hborisov/thermometer/README.md

# thermometer

https://hristoborisov.wordpress.com/digital-thermometer-with-pic-mcu-and-tmp102-sensor/
