hborisov/thermometer/thermometer.png

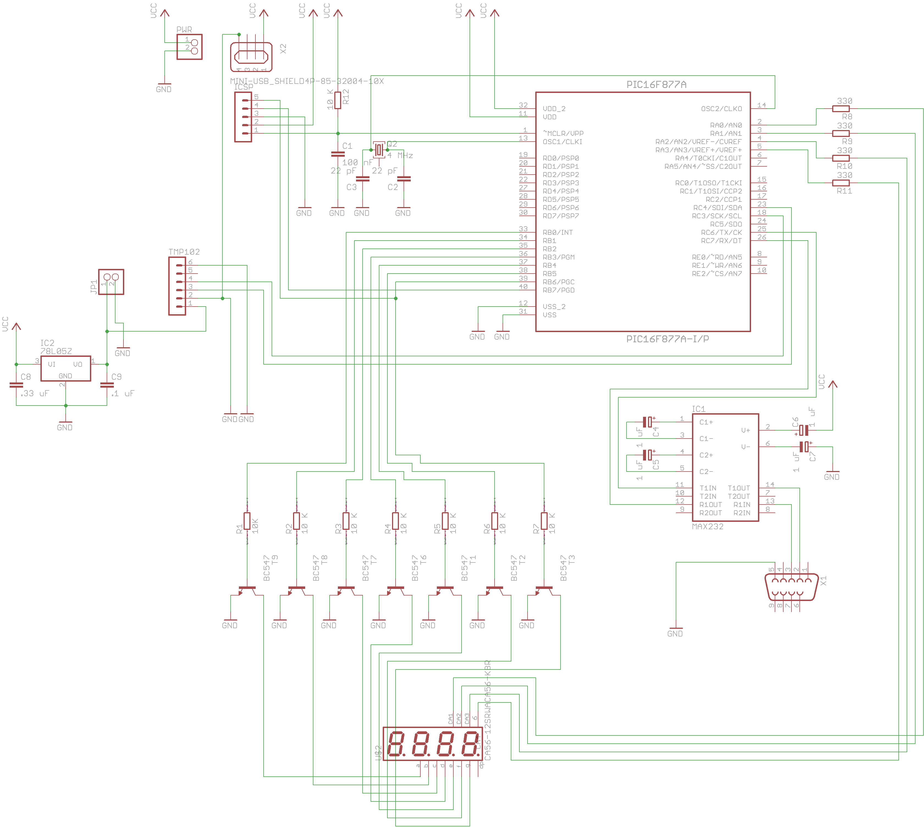
thermometer.png
