hborisov/thermometer/thermometer_brd.png

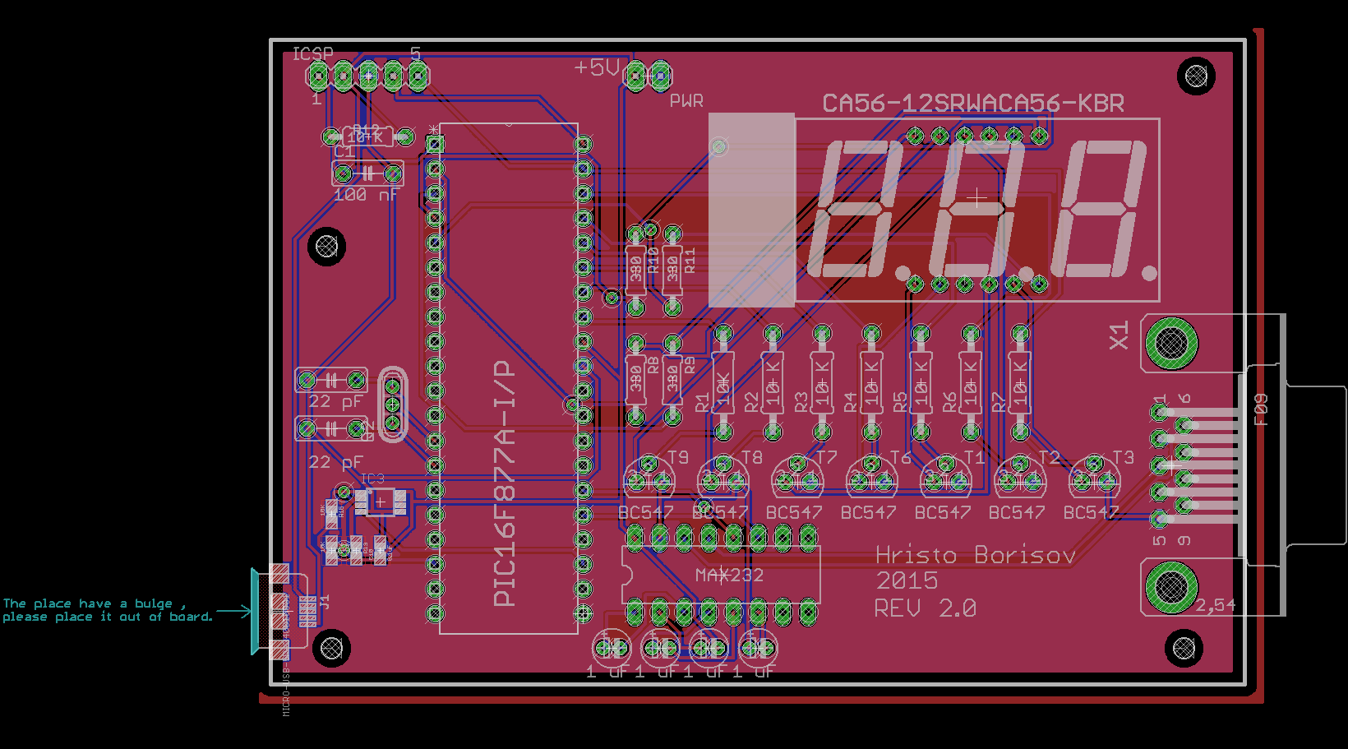
thermometer_brd.png
