hborisov/thermometer/thermometer_sch.png

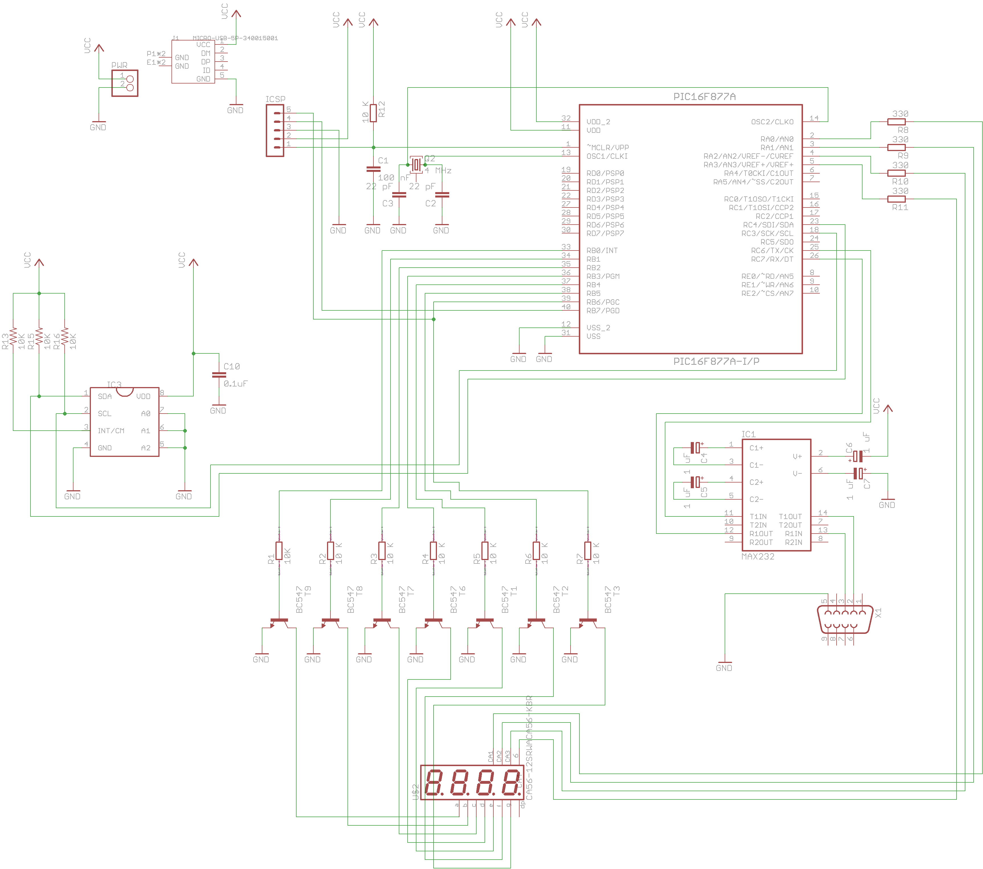
thermometer_sch.png
