hborisov/thermometer/case/rev.1/thermometer_box_top.stl

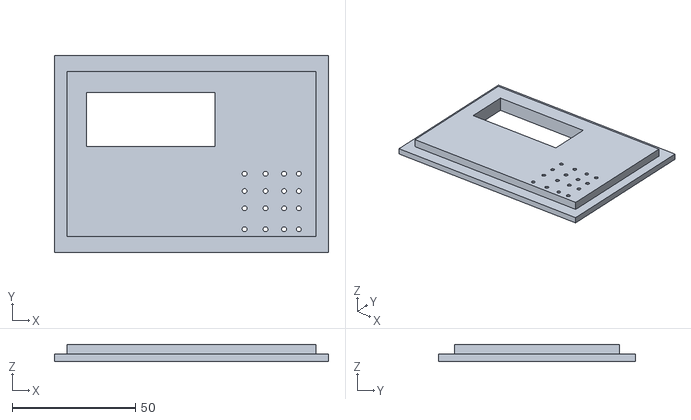
[picture p4: CAD file, 2015-10-23]
case/rev.1/thermometer_box_top.stl
111.0 x 80.0 x 7.00
