hborisov/thermometer/case/rev.1/tremendous_vihelmo.obj

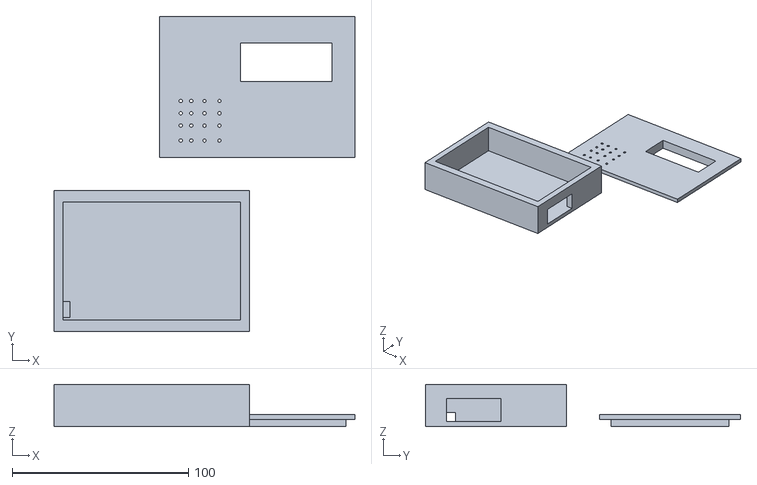
[picture p5: CAD file, 2015-10-23]
case/rev.1/tremendous_vihelmo.obj
171.0 x 179.0 x 24.0
