hborisov/thermometer/case/rev.1/thermometer_box_bottom.stl

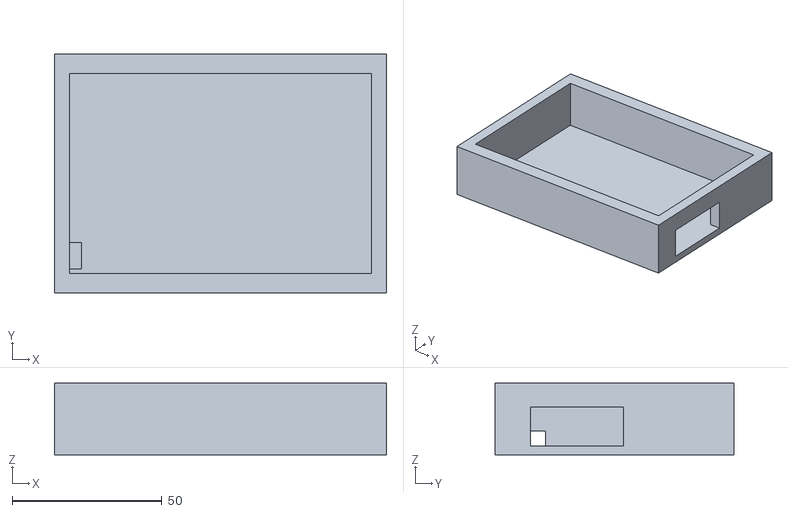
[picture p6: CAD file, 2015-10-23]
case/rev.1/thermometer_box_bottom.stl
111.0 x 80.0 x 24.0
