hborisov/thermometer/(list of files, cad)

Other CAD files:
case/rev.1/thermometer_box.stl
case/rev.1/thermometer_box.amf
