hborisov/thermometer/thermometer.brd

## EAGLE design thermometer.brd (2015-02-23)

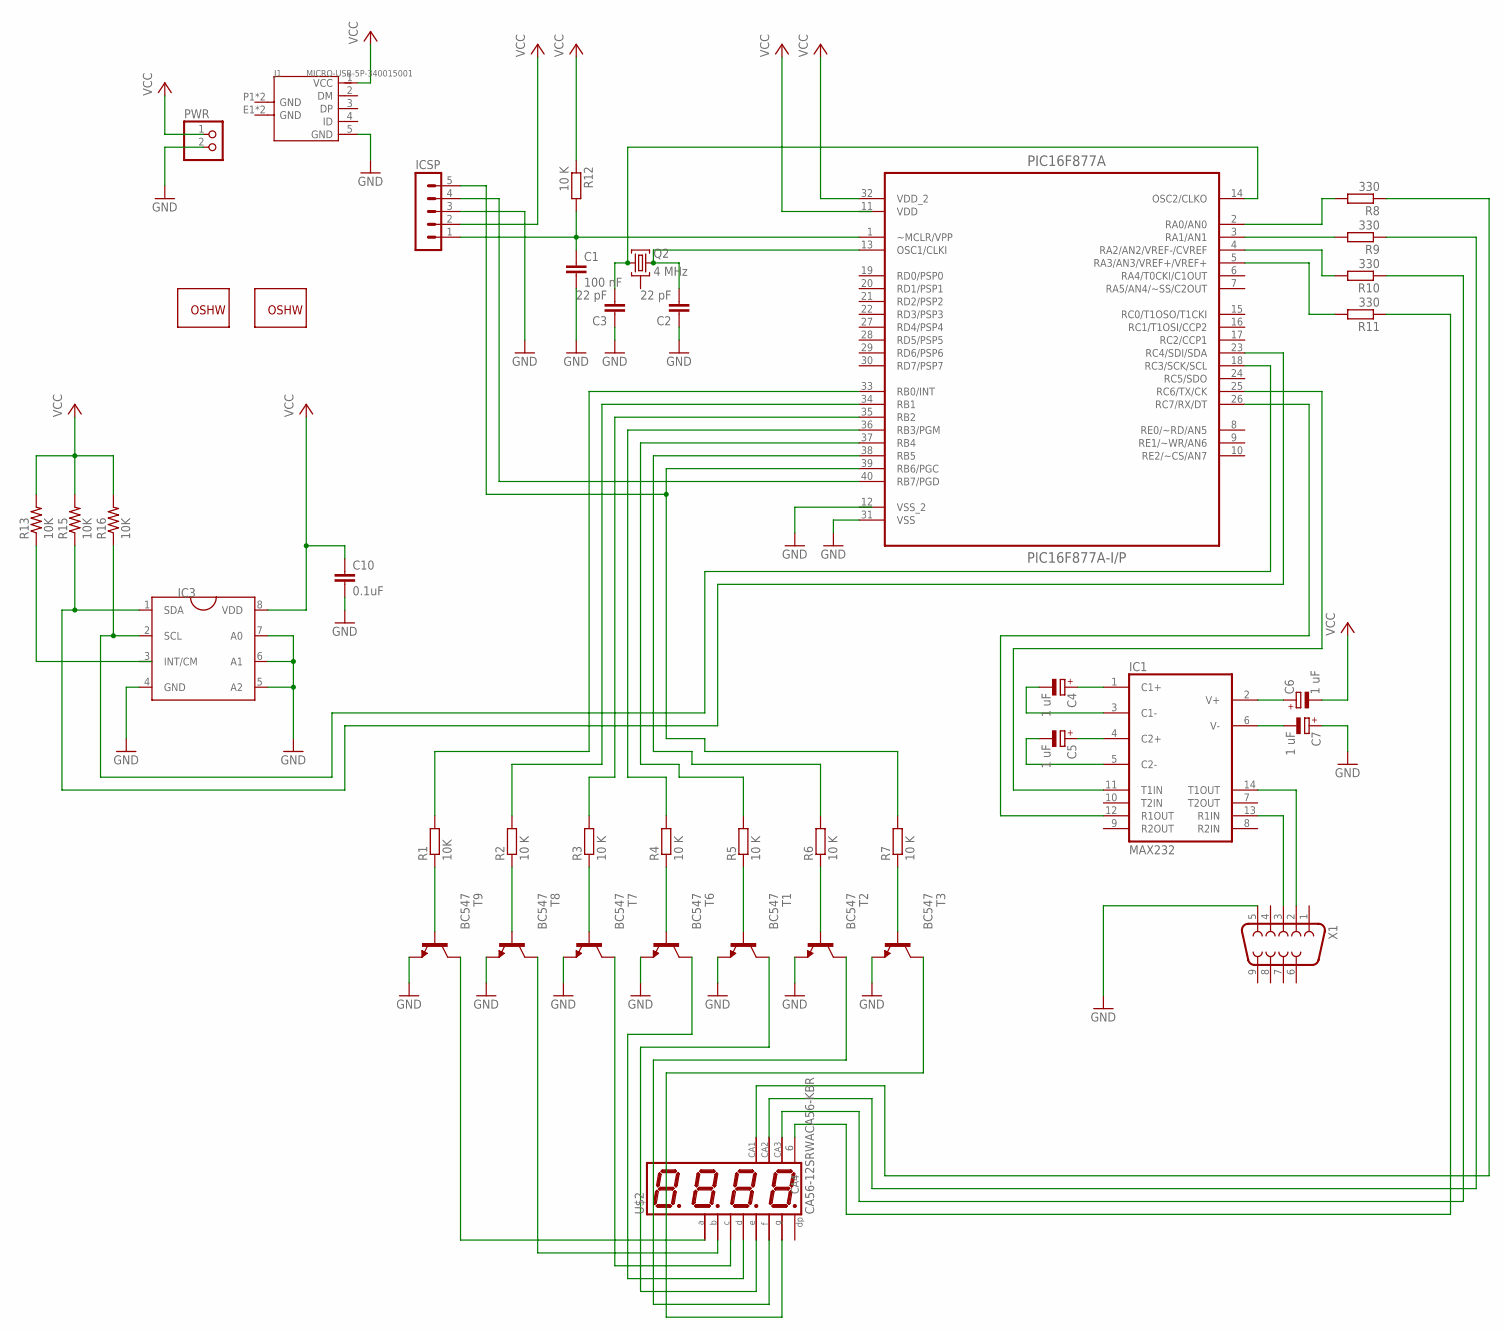
[picture p7: schematic thermometer.sch]

Parts:
C1: 100 nF; C050-025X075
C2, C3: 22 pF; C050-025X075
C4, C5, C6, C7: 1 uF; E1,8-4
C10: 0.1uF; 0603-CAP
GOLD_ORB_SM1: OSHWLOGO_GOLD_ORB_LG; OSHW0
GOLD_ORB_SM2: OSHWLOGO_GOLD_ORB_SM; OSHW2
IC1: MAX232; DIL16
IC3: TCN75TCN75MUA; MSOP8
ICSP: MA05-1
J1: MICRO-USB-5P-340015001; B-SMD-5P
PIC16F877A: PIC16F877A-I/P; DIP254P1524X483-40
PWR: PINHD-1X2; 1X02
Q2: 4 MHz; UM1
R1: 10K; 0207/10
R2, R3, R4, R5, R6, R7: 10 K; 0207/10
R8, R9, R10, R11: 330; 0204/7
R12: 10 K; 0204/7
R13, R15, R16: 10K; 0603-RES
T1, T2, T3, T6, T7, T8, T9: BC547; TO92
U$2: CA56-12SRWACA56-KBR; CA56
X1: F09HP

Connections:
GND: C1.2, C2.1, C3.1, C7.+, C10.2, IC1.15 (GND), IC3.4 (GND), IC3.5 (A2), IC3.6 (A1), IC3.7 (A0), ICSP.3, J1.5 (GND), PIC16F877A.31 (VSS), PWR.2, T1.1 (E), T2.1 (E), T3.1 (E), T6.1 (E), T7.1 (E), T8.1 (E), T9.1 (E), X1.5
unnamed: R1.1, T9.2 (B)
unnamed: R2.1, T8.2 (B)
unnamed: R3.1, T7.2 (B)
unnamed: R4.1, T6.2 (B)
unnamed: R5.1, T1.2 (B)
unnamed: R6.1, T2.2 (B)
unnamed: R7.1, T3.2 (B)
unnamed: PIC16F877A.33 (RB0/INT), R1.2
unnamed: PIC16F877A.34 (RB1), R2.2
unnamed: PIC16F877A.35 (RB2), R3.2
unnamed: PIC16F877A.36 (RB3/PGM), R4.2
unnamed: PIC16F877A.37 (RB4), R5.2
unnamed: PIC16F877A.38 (RB5), R6.2
unnamed: ICSP.5, PIC16F877A.39 (RB6/PGC), R7.2
unnamed: PIC16F877A.2 (RA0/AN0), R8.2
unnamed: PIC16F877A.3 (RA1/AN1), R9.2
unnamed: PIC16F877A.4 (RA2/AN2/VREF-/CVREF), R10.2
unnamed: PIC16F877A.5 (RA3/AN3/VREF+/VREF+), R11.2
unnamed: R8.1, U$2.12 (CA)
unnamed: C1.1, ICSP.1, PIC16F877A.1 (~MCLR/VPP), R12.2
unnamed: R9.1, U$2.9 (CA)
unnamed: R10.1, U$2.8 (CA)
unnamed: T9.3 (C), U$2.11 (A)
unnamed: C2.2, PIC16F877A.13 (OSC1/CLKI), Q2.3
unnamed: T7.3 (C), U$2.4 (C)
unnamed: T6.3 (C), U$2.2 (D)
unnamed: T1.3 (C), U$2.1 (E)
unnamed: T2.3 (C), U$2.10 (F)
unnamed: T3.3 (C), U$2.5 (G)
unnamed: ICSP.4, PIC16F877A.40 (RB7/PGD)
unnamed: R11.1, U$2.6 (CA4)
unnamed: IC3.2 (SCL), PIC16F877A.18 (RC3/SCK/SCL), R16.1
unnamed: IC3.1 (SDA), PIC16F877A.23 (RC4/SDI/SDA), R15.1
unnamed: C7.-, IC1.6 (V-)
unnamed: C3.2, PIC16F877A.14 (OSC2/CLKO), Q2.1
unnamed: C6.+, IC1.2 (V+)
unnamed: C4.+, IC1.1 (C1+)
unnamed: C4.-, IC1.3 (C1-)
unnamed: C5.+, IC1.4 (C2+)
unnamed: C5.-, IC1.5 (C2-)
unnamed: IC1.11 (T1IN), PIC16F877A.25 (RC6/TX/CK)
unnamed: IC1.14 (T1OUT), X1.2
unnamed: IC1.13 (R1IN), X1.3
unnamed: IC1.12 (R1OUT), PIC16F877A.26 (RC7/RX/DT)
unnamed: T8.3 (C), U$2.7 (B)
unnamed: IC3.3 (INT/CM), R13.1
VCC: C6.-, C10.1, IC1.16 (VCC), IC3.8 (VDD), ICSP.2, J1.1 (VCC), PIC16F877A.32 (VDD_2), PWR.1, R12.1, R13.2, R15.2, R16.2
VDD: PIC16F877A.11 (VDD)
VSS_2: PIC16F877A.12 (VSS_2)

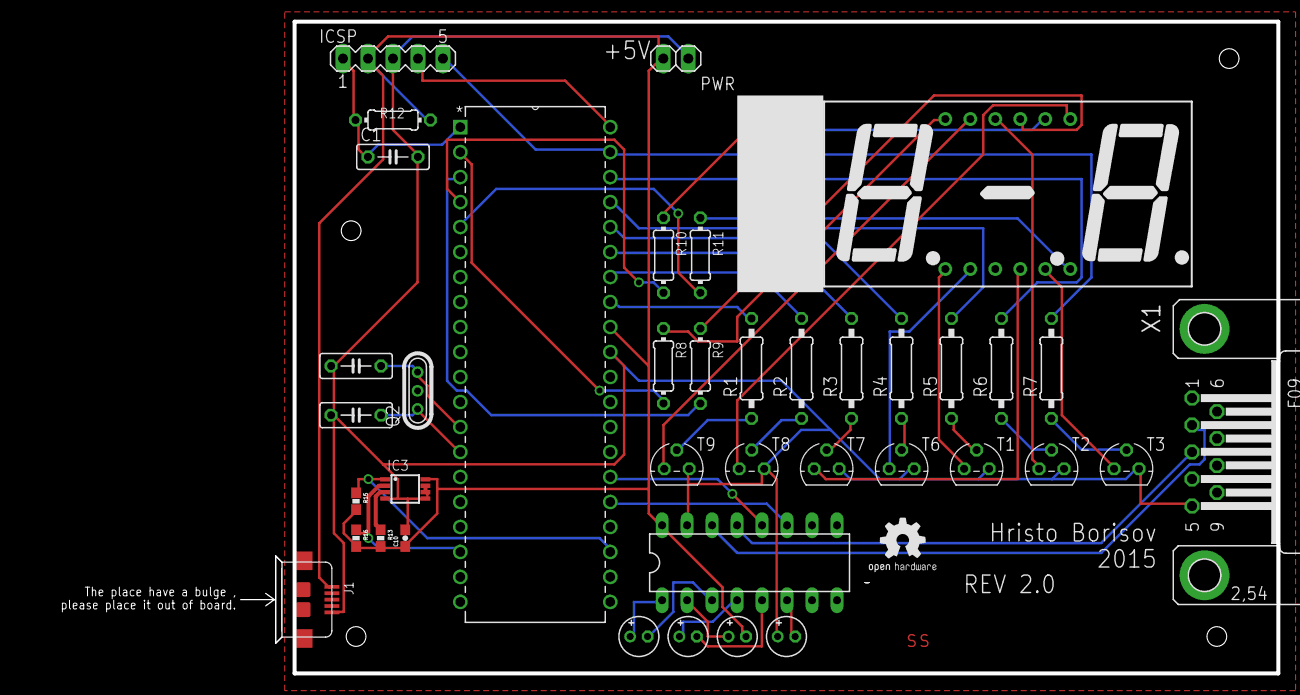
[picture p8: board thermometer.brd from above]

Board: 2 copper layers, 105.5 x 66.2 mm, 41 parts (1 on the bottom side), 48 nets.
