hborisov/thermometer/(threads)

Thread 2 (2015-02-21):

The two pin power connector is too close to the icsp connector and the programmer cannot be fully plugged in.

hborisov, 2015-02-21:

Closed 2015-02-21.

Thread 3 (2015-02-21):

T9 and T8 collectors are short circuited - This is wrong!

hborisov, 2015-02-21:

Closed 2015-02-21.
