hborisov/thermometer/(commit log)

2015-02-18 Thermometer circuit and board v1.0
    [thermometer.brd, thermometer.sch]
2015-02-21 v 1.1 released. Several bug fixes
    [thermometer.brd, thermometer.sch]
2015-02-21 Adding schematic and board as images
    [thermometer.brd, thermometer.sch]
2015-02-23 Version 2.0 with TCN75 and USB Micro B
    [thermometer.brd, thermometer.sch]
2015-02-23 Adding schematic and board pictures
2015-02-23 Changing schematic pictures
2015-02-23 Adding some text and Open Hardware logo
    [thermometer.brd, thermometer.sch]
2015-06-25 added workaround for faulty reading on tcn75
    [main.asm]
2015-10-23 Adding box rev 1 3d model.
    [thermometer_box.amf, thermometer_box.stl, thermometer_box_bottom.stl, thermometer_box_top.stl, tremendous_vihelmo.obj]
